Juventus-Technikerschule-HF/EduboardV2_ATmega328PB/Datasheet/XplainedYourself_1.1.0/XYS_1.1.0.png

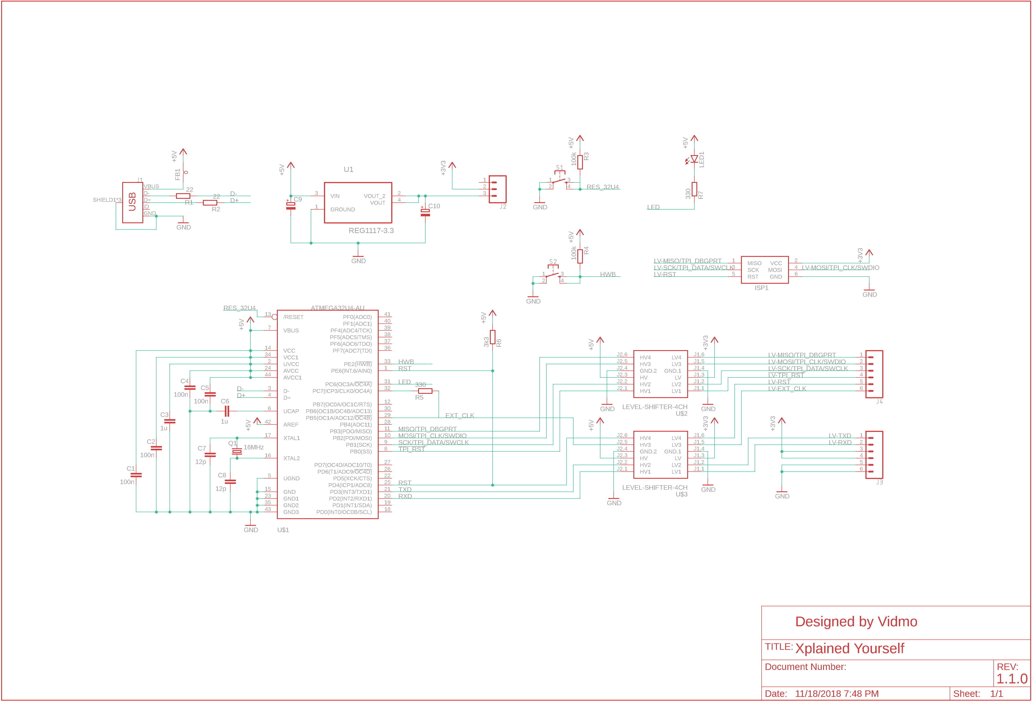
Datasheet/XplainedYourself_1.1.0/XYS_1.1.0.png
