Juventus-Technikerschule-HF/EduboardV2_ATmega328PB/EduboardV2_ATmega328PB.step

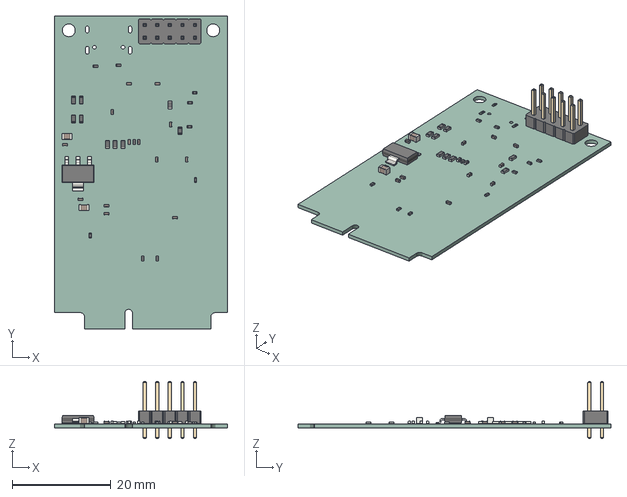
[picture p2: CAD file, 2023-04-25]
EduboardV2_ATmega328PB.step
35.0 x 63.3 x 11.5 mm
PCB
