Juventus-Technikerschule-HF/EduboardV2_ATmega328PB/EduboardV2_ATmega328PB.kicad_pcb

## KiCad design EduboardV2_ATmega328PB.kicad_pcb (2023-06-26)

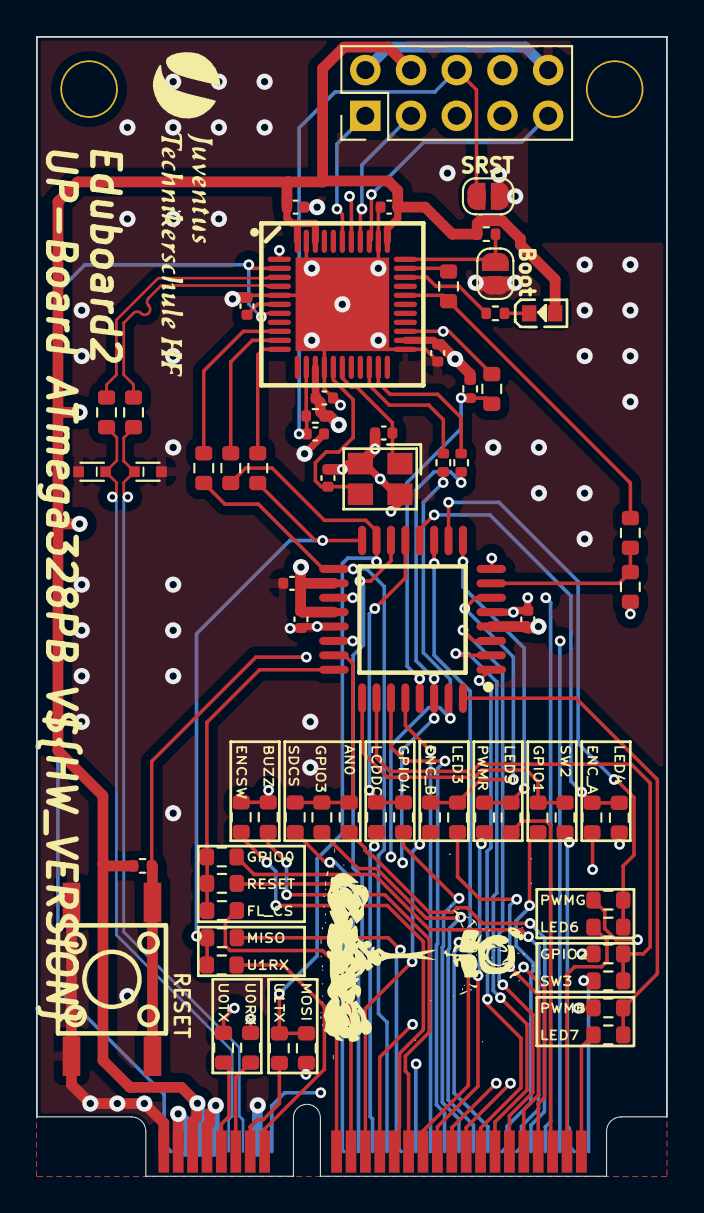
[picture p3: board EduboardV2_ATmega328PB.kicad_pcb from above]

Board: 4 copper layers, 35.0 x 63.3 mm, 68 parts (0 on the bottom side), 85 nets.

Parts:
C1, C2, C3, C4, C7, C8, C9, C10, C11: 100n; C_0402_1005Metric
C5, C6: 12p; C_0402_1005Metric
D1, D2: LESD5D5.0CT1G; SOD-523_L1.2-W0.8-LS1.6-BI
J1: EduboardV2 PCIE UP Board Connector; mini-PCIe_F1_Full
J2: JTAG_mEDBG; PinHeader_2x05_P2.54mm_Vertical
JP1, JP2: SolderJumper_2_Open; SolderJumper-2_P1.3mm_Open_RoundedPad1.0x1.5mm
LED1: 19-217/BHC-ZL1M2RY/3T; LED0603-FD_BLUE
R1, R2, R3, R4, R5, R6, R7, R8, R9, R10, R11, R12, R13, R14, R15, R16, R17, R18, R19, R20, R21, R22, R23, R24, R25, R26, R27, R30, R31, R32, R33, R34, R37, R38, R40: 0R; R_0603_1608Metric
R28, R29: 1k; R_0402_1005Metric
R35: 10k; R_0402_1005Metric
R36, R45: 3k3; R_0402_1005Metric
R39, R46: 100k; R_0402_1005Metric
R41, R42, R43, R44: 330R; R_0603_1608Metric
SW1: K2-1102SP-C4SC-04; KEY-SMD_4P-L6.0-W6.0-P4.50-LS9.5-BL
U1: ATMEGA328PB-AUR; TQFP-32_L7.0-W7.0-P0.80-LS9.0-BL
U2: ATMEGA32U4-MU; VQFN-44_L7.0-W7.0-P0.50-BL-EP5.2
X1: M16000E067; CRYSTAL-SMD_4P-L3.2-W2.5-BL

Connections:
+3V3: C1.1, C2.1, C3.1, C8.1, C9.2, C10.2, C11.2, J1.5 (3.3V), J1.6 (3.3V), J2.4, LED1.2 (A), R35.1, R39.2, R45.2, R46.2, U1.4 (VCC), U1.18 (AVCC), U1.20 (AREF), U2.14 (VCC), U2.24 (AVCC), U2.34 (VCC), U2.42 (AREF), U2.44 (AVCC)
+5V: J1.3 (5V), J1.4 (5V)
CLK_OUT: R44.2, U2.32 (PC7(ICP3/CLK0/OC4A))
EXT_CLK: R10.1, R44.1, U2.29 (PB5(PCINT5/OC1A/~OC4B/ADC12))
GND: C1.2, C2.2, C3.2, C4.2, C5.2, C6.2, C7.2, C8.2, C9.1, C10.1, C11.1, D1.1, D2.1, J1.1 (GND), J1.7 (GND), J1.8 (GND), J1.14 (GND), J2.2, J2.10, JP1.1 (A), JP2.2 (B), SW1.3, SW1.4, U1.5 (GND), U1.21 (GND), U2.5 (UGnd), U2.15 (GND), U2.23 (GND), U2.35 (GND), U2.43 (GND), U2.45 (EP), X1.2 (GND), X1.4 (GND)
GPIOX0: J1.42 (GPIOX0/AN1/I2S_DOUT), R25.2
GPIOX1: J1.40 (GPIOX1/AN2/I2S_DIN), R30.2
GPIOX2: J1.38 (GPIOX2/AN3/I2S_LRCK), R32.2
GPIOX3: J1.36 (GPIOX3/AN4/I2S_SCLK), R23.2
GPIOX4: J1.34 (GPIOX4/AN5/I2S_MCLK), R11.2
GPIO_AN0: J1.44 (AN0/Pot0), R21.2
GPIO_Buzzer: J1.27 (Buzzer), R2.2
GPIO_FLASH_CS: J1.17 (~FLASH_CS), R26.2
GPIO_LED0: J1.37 (LED0), U1.1 ((OC2B/INT1/PTCXY)PD3)
GPIO_LED1: J1.39 (LED1), U1.2 ((XCK0/T0/PTCXY)PD4)
GPIO_LED2: J1.41 (LED2), U1.3 ((SDA1/ICP4/ACO/PTCXY)PE0)
GPIO_LED3: J1.43 (LED3), R14.1
GPIO_LED4: J1.45 (LED4), R9.2
GPIO_LED5: J1.47 (LED5), R4.2
GPIO_LED6: J1.49 (LED6), R6.2
GPIO_LED7: J1.51 (LED7), R19.1
GPIO_PWM_B: J1.35 (PWM_B), R20.1
GPIO_PWM_G: J1.33 (PWM_G), R5.2
GPIO_PWM_R: J1.31 (PWM_R), R3.2
GPIO_RotEnc_A: J1.23 (RotEnc_A), R7.2
GPIO_RotEnc_B: J1.21 (RotEnc_B), R12.1
GPIO_RotEnc_SW: J1.25 (RotEnc_SW), R1.2
GPIO_SD_CS: J1.19 (~SD_CS), R22.2
GPIO_SW0: J1.46 (SW0), U1.19 (PE2(ADC6/PTCY/ICP3/SS1#))
GPIO_SW1: J1.48 (SW1), U1.22 (PE3(ADC7/PTCY/T3/MOSI1))
GPIO_SW2: J1.50 (SW2), R27.2
GPIO_SW3: J1.52 (SW3), R31.2
GPIO_WS2812_DATA: J1.29 (WS2812_Data), U1.11 ((PTCXY/AIN1)PD7)
LCD_CS: J1.20 (~TFT_CS), U1.14 (~(SS0/OC1B/PTCXY)PB2)
LCD_DC: J1.22 (TFT_DC), R13.2
unnamed: J1.11 (UART0_UP_RX), R34.2
unnamed: J1.9 (UART0_UP_TX), R33.2
unnamed: JP2.1 (A), R46.1, U2.33 (PE2(HWB#))
unnamed: LED1.1 (C), R36.2
unnamed: R7.1, R9.1, U1.12 ((ICP1/CLKO/PTCXY)PB0)
unnamed: R5.1, R6.1, U1.10 ((OC0A/PTCXY/AIN0)PD6)
unnamed: R3.1, R4.1, U1.9 ((OC0B/T1/PTCXY)PD5)
unnamed: R11.1, R13.1, U1.13 ((OC1A/PTCXY)PB1)
unnamed: R12.2, R14.2, U1.6 ((SCL1/T4/PTCXY)PE1)
unnamed: R8.2, R10.2, U1.7 ((XTAL1/TOSC1)PB6)
unnamed: R1.1, R2.1, U1.8 ((XTAL2/TOSC2)PB7)
unnamed: R21.1, R22.1, R23.1, U1.23 (PC0(ADC0/PTCY/MISO1))
unnamed: R24.1, R25.1, R26.1, U1.24 (PC1(ADC1/PTCY/SCK1))
unnamed: R27.1, R30.1, U1.25 (PC2(ADC2/PTCY))
unnamed: R31.1, R32.1, U1.26 (PC3(ADC3/PTCY))
unnamed: R19.2, R20.2, U1.32 (PD2(PTCXY/INT0/OC3B/OC4B))
unnamed: C7.1, U2.6 (UCap)
unnamed: C6.1, U2.17 (XTAL1), X1.1 (OSC1)
unnamed: C5.1, U2.16 (XTAL2), X1.3 (OSC2)
PROG_SPI_MISO: R42.2, U2.11 (PB3(PDO/PCINT3/MISO))
PROG_SPI_MOSI: R43.2, U2.10 (PB2(PDI/PCINT2/MOSI))
PROG_SPI_SCK: R41.2, U2.9 (PB1(PCINT1/SCLK))
PROG_UART_RX: R28.2, U2.20 (PD2(RXD1/INT2))
PROG_UART_TX: R29.2, U2.21 (PD3(TXD1/INT3))
RS485_DE: J1.16 (RS485_DE), R8.1
SCL: J1.30 (SCL), U1.28 (PC5(ADC5/PTCY/SCL0))
SDA: J1.32 (SDA), U1.27 (PC4(ADC4/PTCY/SDA0))
SPI_MISO: J1.26 (SPI_MISO), R17.2
SPI_MOSI: J1.28 (SPI_MOSI), R16.2
SPI_SCK: J1.24 (SPI_SCK), R41.1, U1.17 (PB5(PTCXY/XCK1/SCK0))
STATUS_LED: R36.1, U2.31 (PC6(OC3A/OC4A#))
TCK: J2.1, U2.39 (PF4(ADC4/TCK))
TDI: J2.9, U2.36 (PF7(ADC7/TDI))
TDO: J2.3, U2.37 (PF6(ADC6/TDO))
TMS: J2.5, U2.38 (PF5(ADC5/TMS))
UART0_RX: R29.1, R34.1, U1.30 (PD0(PTCXY/OC3A/RXD0))
UART0_TX: R28.1, R33.1, U1.31 (PD1(PTCXY/OC4A/TXD0))
UART1_RX: J1.15 (UART1_RS485_RX), R18.2
UART1_TX: J1.13 (UART1_RS485_TX), R15.2
UP_SPI_MISO: R17.1, R18.1, R42.1, U1.16 ((MISO0/RXD1/PTCXY)PB4)
UP_SPI_MOSI: R15.1, R16.1, R43.1, U1.15 ((MOSI0/TXD1/OC2A/PTCXY)PB3)
USB_Debug_D+: D2.2, J1.12 (USB_Debug_D+), R38.1
USB_Debug_D-: D1.2, J1.10 (USB_Debug_D-), R37.1
USB_N: R37.2, U2.3 (D-)
USB_P: R38.2, U2.4 (D+)
VBUS: J1.2 (V_USB), U2.2 (UVcc), U2.7 (VBus)
debugWire: R40.2, U2.1 (PE6(INT.6/AIN0)), U2.25 (PD4(ICP1/ADC8))
~General_Reset: J1.18 (~General_Reset), R24.2
~RESET_DW: R35.2, R40.1, R45.1, SW1.1, SW1.2, U1.29 (PC6(RESET#))
~SRST: C4.1, J2.6, JP1.2 (B), R39.1, U2.13 (~RESET)
