Juventus-Technikerschule-HF/EduboardV2_ATmega328PB/(threads)

Thread 1 (2023-05-27):

VCC at C5/U1 not connected

mburger82, 2023-05-27:
No 3.3V on U1:14(VCC) therefore chip does not run oscillator.

mburger82, 2023-06-25:
done f1180cd3c9982fcdb981d389b2e01fd97e14d0ce

Closed 2023-06-25.

Thread 2 (2023-05-27):

JP34 default routing wrong

mburger82, 2023-05-27:
Default routing should go to SPI_MISO, not tu UART1_RX

mburger82, 2023-06-25:
fixed de92006264289168182a74ac4b2d83441b846f0e

Closed 2023-06-25.

Thread 3 (2023-05-28):

MISO/MOSI from ATMega32u4 to 328pb switched.

mburger82, 2023-05-28:
The Description in the original pdf from microchip is very misleading. The Pinout of the Connectors on one page is different than on the other page...

mburger82, 2023-06-25:
fixed a3b437ec9f929c3a53aa804974fb77d0813b251d

Closed 2023-06-25.

Thread 4 (2023-05-29):

Get rid of USB Port on UP Board. Not nescessary

mburger82, 2023-05-29:
This would simplify the Power routing significantly. The Ideal Diodes on the Baseboard would not be nescessary anymore then.

mburger82, 2023-06-25:
done 8533e4afa32d29100646489f0da2629385fa18c4

Closed 2023-06-25.

Thread 8 (2023-07-01):

Remove Soldermask from m.2 pins to prevent ENIG getting battered with solder!

mburger82, 2023-07-01:
