Juventus-Technikerschule-HF/EduboardV2_ATmega328PB/(commit log)

2023-04-23 create atmega328 board. Not yet sure if this small microcontroller will be enough for our purposes
    [DebugChip.kicad_sch, EduboardV2_ATmega328PB.kicad_pcb, EduboardV2_ATmega328PB.kicad_sch, XYS_1.1.0.sch]
2023-04-24 start distribute pins to signals.
    [DebugChip.kicad_sch, EduboardV2_ATmega328PB.kicad_sch]
2023-04-25 schematic done. layout done aswell. Have to check everything trice
    [DebugChip.kicad_sch, EduboardV2_ATmega328PB.kicad_pcb, EduboardV2_ATmega328PB.kicad_sch]
2023-04-25 ready for order first prototype
    [DebugChip.kicad_sch, EduboardV2_ATmega328PB.kicad_pcb, EduboardV2_ATmega328PB.step, bom.csv, designators.csv, positions.csv]
2023-05-09 got first prototypes. Found some errors. not yet corrected, but marked.
    [DebugChip.kicad_sch, EduboardV2_ATmega328PB.kicad_sch]
2023-06-25 change mounting hole size to 3mm
    [EduboardV2_ATmega328PB.kicad_pcb]
2023-06-25 remove voltage regulator and change sense input to 3.3V
    [DebugChip.kicad_sch, EduboardV2_ATmega328PB.kicad_sch]
2023-06-25 remove USBC Connector, but keep the esd protection
    [DebugChip.kicad_sch]
2023-06-25 add VCC to Pin14 of the atmega32u4
    [DebugChip.kicad_sch]
2023-06-25 switch miso/mosi from atmega32u4 to atmega328
    [DebugChip.kicad_sch]
2023-06-25 switch default routing of j34 miso/uart_rx
    [EduboardV2_ATmega328PB.kicad_sch]
2023-06-25 change version to 1.1
    [EduboardV2_ATmega328PB.kicad_pcb]
2023-06-26 arrange parts and layout v1.1.
    [DebugChip.kicad_sch, EduboardV2_ATmega328PB.kicad_pcb, EduboardV2_ATmega328PB.kicad_sch]
2023-06-26 create production data
    [EduboardV2_ATmega328PB.kicad_pcb, bom.csv, designators.csv, positions.csv]
